ccadic/RPi0WGameStation/20171103_110615.jpg

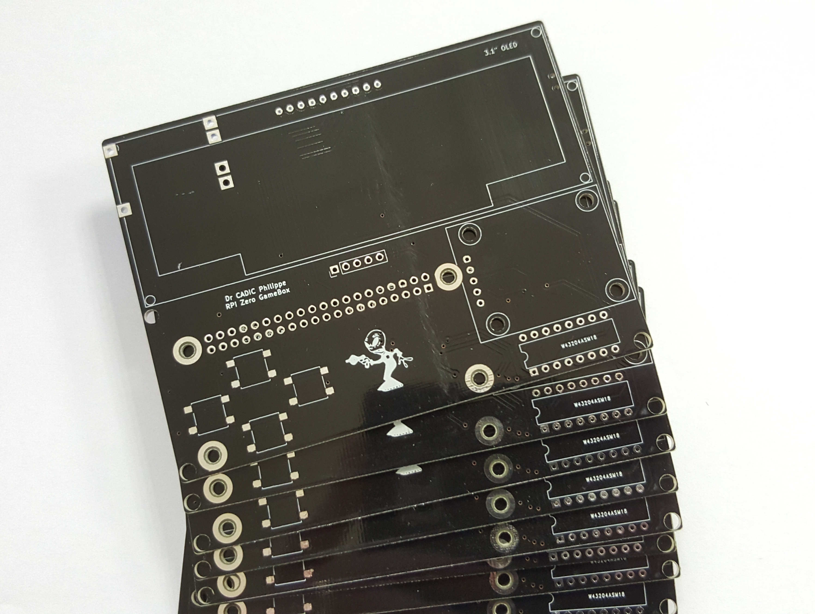
20171103_110615.jpg
