ccadic/RPi0WGameStation/23473068_10214847813298589_1204559804403609338_n.jpg

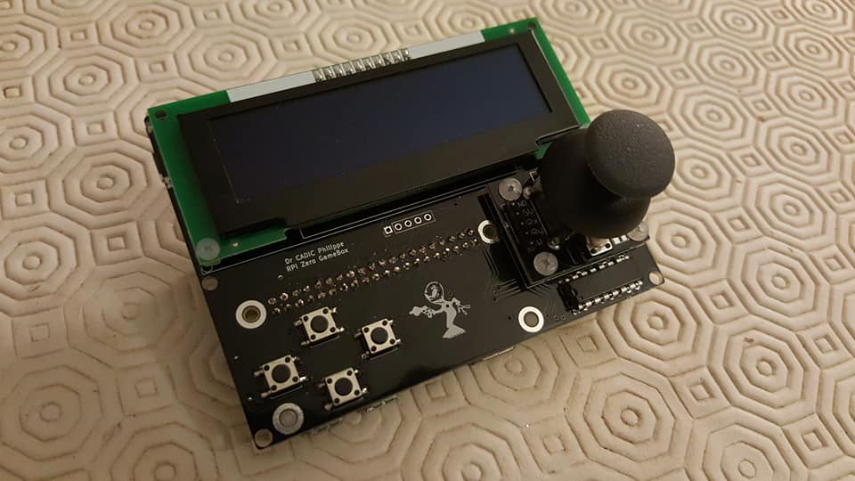
23473068_10214847813298589_1204559804403609338_n.jpg
