ccadic/RPi0WGameStation/README.md

# RPi0WGameStation
PCB to make a RPI0 based game station or WIFI remote controler
