ccadic/RPi0WGameStation/Projet de Console de jeu Raspberry Pi 0.pdf

# Projet de Console de jeu Raspberry Pi 0

DR PHILIPPE CADIC (https://www.linkedin.com/in/dr-philippe-cadic-883a15122/)

Ce mois si , j'ai continué à découvrir le logiciel KICAD (http://kicad-pcb.org/) pour concevoir un petit projet rigolo: une petite console de jeu basée sur une architecture simple de type Raspberry Pi Zero (https://www.raspberrypi.org/products/raspberry-pi-zero/) . Le challenge était sympathique et intéressant pour un débutant en conception de PCB. Derrière cette réalisation, il y a l'idée d'en faire une plateforme de pilotage de robot Pepper ou Buddy.

La recherche des composants pouvant être intéressants s'est faite, le plus simplement du monde, par rédaction d'un rapide cahier des charges:

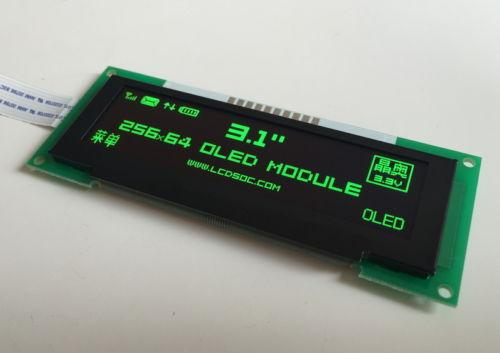
[picture p3: figure]

- Un raspberry pour le coeur du système
- Un écran un peu sympa OLED monochrome avec une librairie qui serait aisée à implémenter sous RPI Linux.
- Une batterie de bonne capacité, rechargeable via USB et amovible pour les longs trajets en train/avion où, forcément il faudrait disposer de munitions.
- Un Joystick bas prix
- Une collection de 4 ou 5 boutons
- Un interrupteur pour .... à votre avis?
- Un circuit chargeur de batterie

### Les recherches composants

Ces recherches ont été faites sur Aliexpress (https://fr.aliexpress.com/) (sauf pour le RPi). (https://fr.aliexpress.com/item/2017-Raspberry-Pi-Zero-W-Board-1GHz-CPU-512MB-RAM-with-WIFI-Bluetooth-RPI-0-W/32802521209.html) Vous trouverez les liens vers les composants , pour éventuellement, cheminer dans mes pas.

- 18650 Batterie (https://fr.aliexpress.com/item/2pcs-lot-18650-battery-ncr18650b-3400mah-for-panasonic-new-100-original-3-7v-rechargeable-battery-hot/32659824635.html) 3.7v

- Le porte batterie (https://fr.aliexpress.com/item/5Pcs-lot-18650-Battery-Holder-SMD-18650-Battery-Storage-Box-High-Quality-With-Bronze-Pins-TBH/32542773400.html)
- L'écran OLED (https://fr.aliexpress.com/item/3-1-inch-10PIN-Green-OLED-Module-SSD1322-Drive-IC-256-64-SPI-Interface-5V/32264789782.html) 3,1"
- Les boutons SMD (https://fr.aliexpress.com/item/1000pcs-MINI-micro-Slide-Switch-On-OFF-2-Position-1P2T-SPDT-Miniature-Horizontal-Slide-Switch-SMD/32770868105.html) et ceux ci (https://fr.aliexpress.com/item/Details-about-140pcs-14types-Momentary-Tact-Tactile-Push-Button-Switch-SMD-Assortment-Kit-Set-Life-100000/32698545030.html) aussi
- Un Joystick Arduino KY-023 (https://fr.aliexpress.com/item/1PCS-LOT-Dual-axis-XY-Joystick-Module-Free-Shipping-for-arduino-KY-023/32725960920.html)
- Un système de recharge de batterie (https://fr.aliexpress.com/item/2pcs-Lithium-Battery-Charger-Module-1A-Micro-USB-5V-18650-TP4056-MIni-USB-Lithium-Battery-Charging/32593738140.html) 1 A USB de type TP4056 (pas besoin de réinventer la roue. Ca existe tout fait , facile à ajouter)
- Un set de résistances (https://fr.aliexpress.com/item/1206-10K-ohm-5-1-4W-Resistor-3216-103-Chip-resistor-500Pcs-Lot/32601535320.html) SMD 1206.
- Des strip sockets 40 pins (https://fr.aliexpress.com/item/10-Pcs-Lot-Raspberry-Pi-Zero-Male-Stackable-Prototyping-Header-Right-Angle-2x20-Pins-Size-3/32570732891.html) (2x20) pour RPi
- Un circuit intégré MCP3008 (https://fr.aliexpress.com/item/10-PCS-LOT-MCP3008-I-P-MCP3008-DIP-Original/32735896933.html) (indispensable pour convertir l'analogique du joystick en signal numérique)
- Des vis et écrous en plastique

### La conception de la plaque imprimée

Pas de grosse difficulté pour ce projet puisque tout a déjà été inventé depuis longtemps. Il s'agit juste d'assembler le Lego sous KICAD. Schéma basique. Le plus long n'étant, finalement, que la partie développement des librairies de composants, des empreintes (footprints) et des rendering 3D de composants. (Lien GITHUB) (https://github.com/ccadic/RPi0WGameStation)

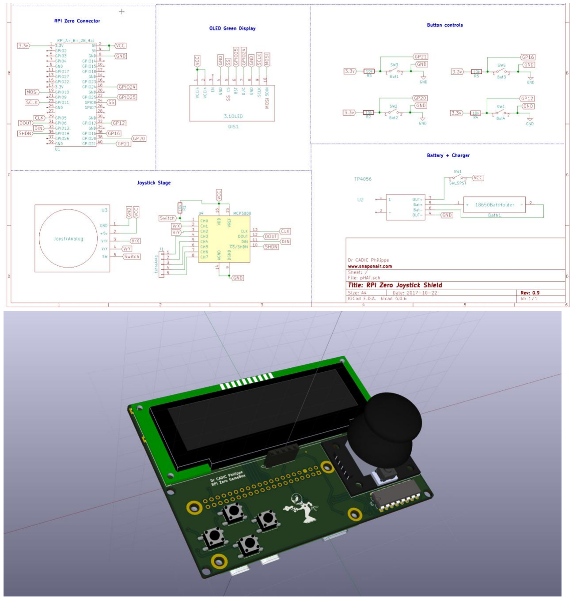
[picture p4: figure]

La plaque PCB est double face. J'ai choisi des composants SMD 1206 pour simplifier la réalisation des soudures à la main. L'assemblage nécessite quelques précautions dans sa chronologie: monter le joystick d'abord, puis souder les boutons et le MCP3008, enfin monter et souder le RPi ZeroW, la plaque TP4056 et en dernier l'écran. La plaque imprimée permet d'avoir 5 entrées analogiques de plus. je ne l'ai pas cablée.

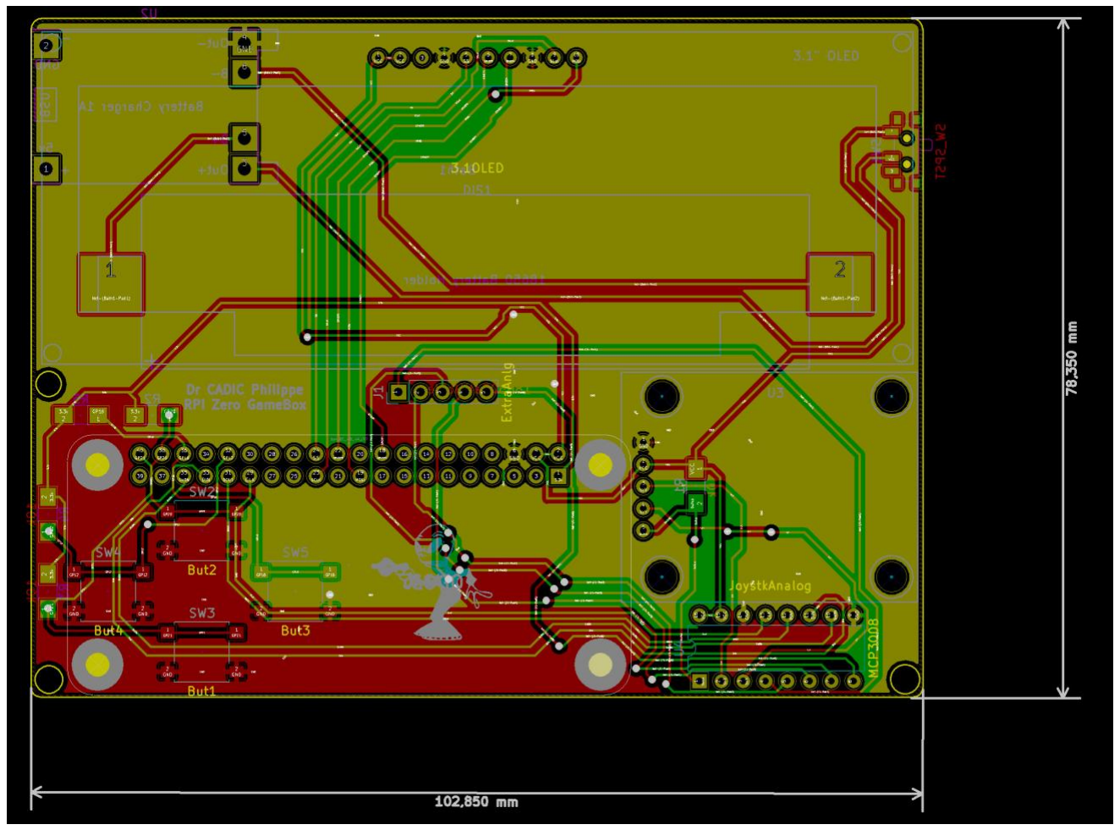
[picture p5: figure]

Si vous voulez avoir une plaque PCB toute faite c'est ici, (https://www.tindie.com/products/electronictrik/rpi0w-game-station-pcb-only/) je n'ai qu'un stock limité.

Une fois montée, ca donne ceci

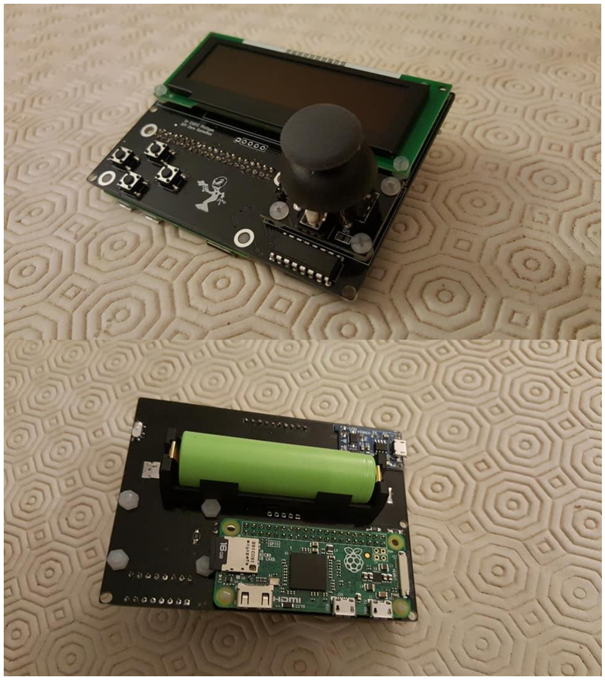
[picture p6: figure]

### Charger le logiciel et le configurer

Rien de sorcier pour l'installation: une Raspbian stretch lite (https://www.raspberrypi.org/downloads/raspbian/) , une carte SD 32 Go (la plus rapide possible en transfert de data).

Le driver SSD1322 ne pose pas de vrai problème d'installation. Il suffit d'aller sur Luma-Oled (http://luma-oled.readthedocs.io/en/latest/intro.html) et de suivre, pas à pas l'installation.

Une fois l'installation complete, il convient de concevoir un script de lancement du logiciel/jeu python , de chmoder 755 pour le rendre exécutable, de le mettre dans /root/startup/mon_script . Puis de modifier votre /etc/rc.local en y ajoutant la ligne de commande.

Pour votre information, bien que nous testé, il existe des sources github des drivers oled ssd1322 (https://github.com/presslab-us/fbtft) pour rediriger la console sur l'ecran oled

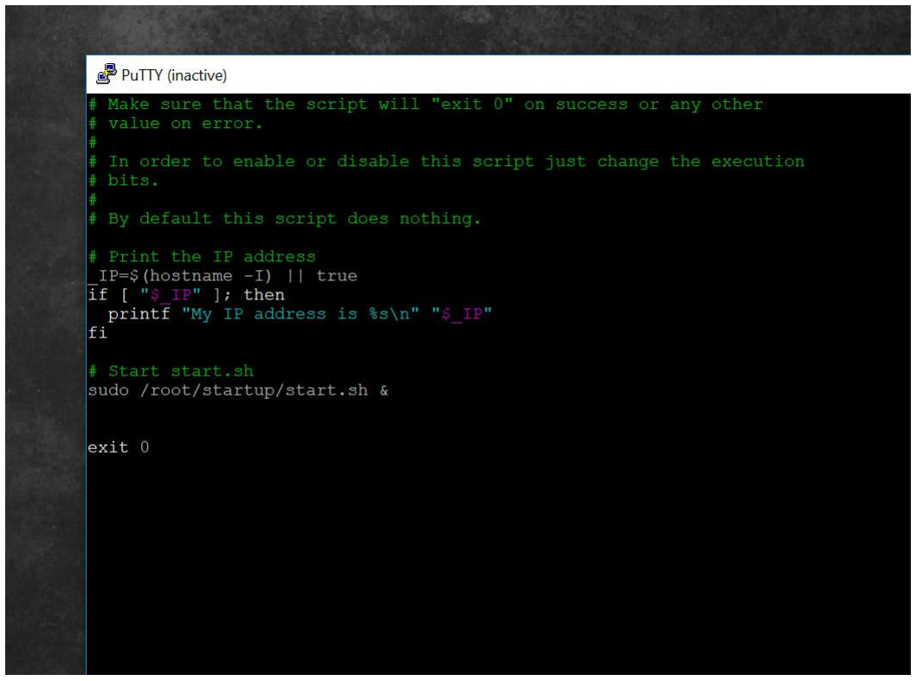
[picture p7: figure]

Ce qui permet de tester le système sur un script d'exemple livré avec LUMA OLED.

Il ne vous reste plus qu'à développer les jeux.

En espérant que ce petit article vous aura incité à vous lancer aussi.
