ccadic/RPi0WGameStation/23473220_10214847813778601_2224835878698296040_n.jpg

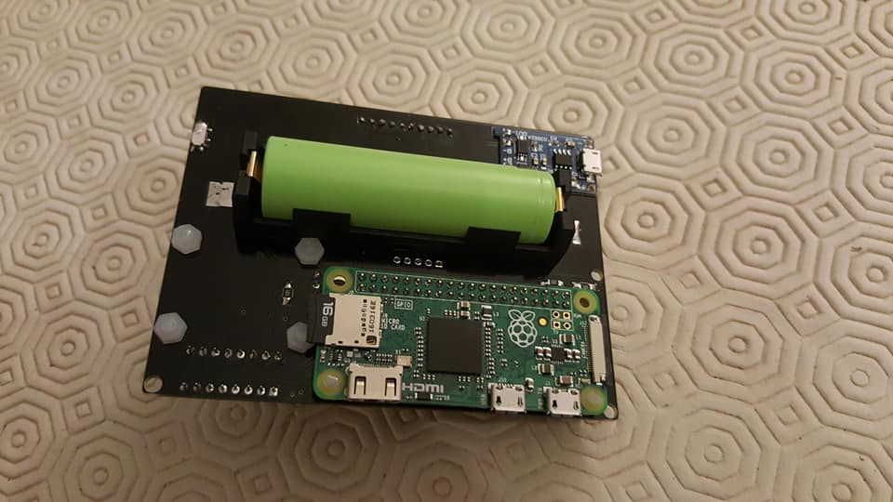
23473220_10214847813778601_2224835878698296040_n.jpg
