ccadic/RPi0WGameStation/front_n.jpg

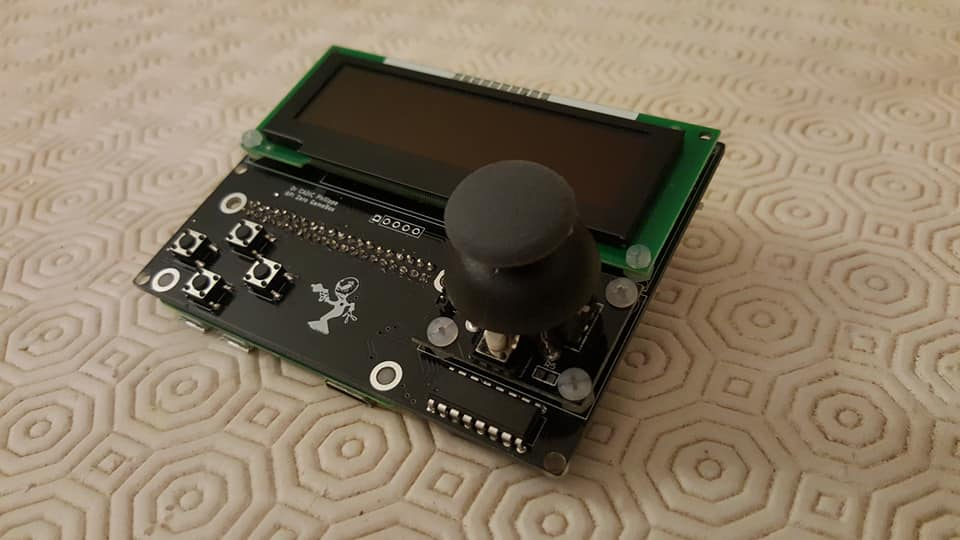
front_n.jpg
