ccadic/RPi0WGameStation/pHAT/console2.jpg

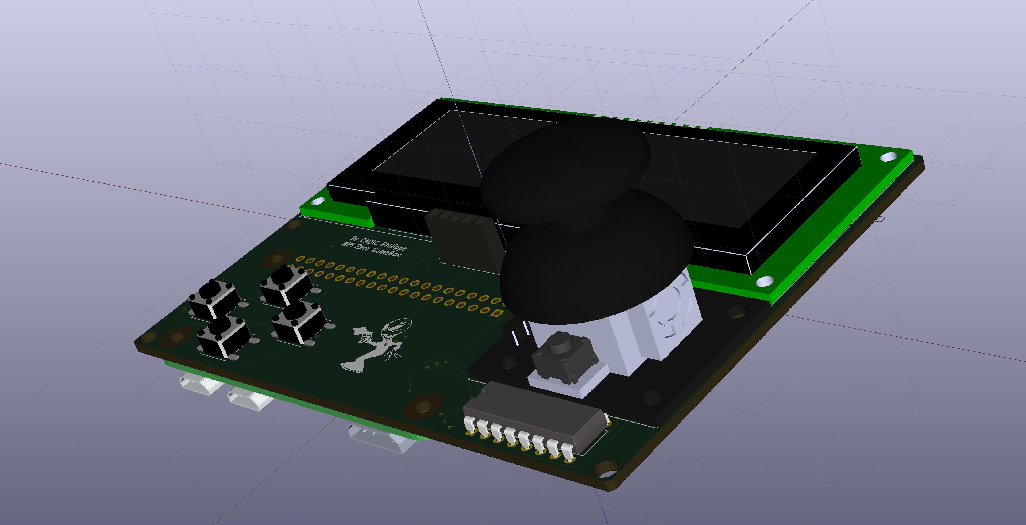
pHAT/console2.jpg
