ccadic/RPi0WGameStation/pHAT/console3.jpg

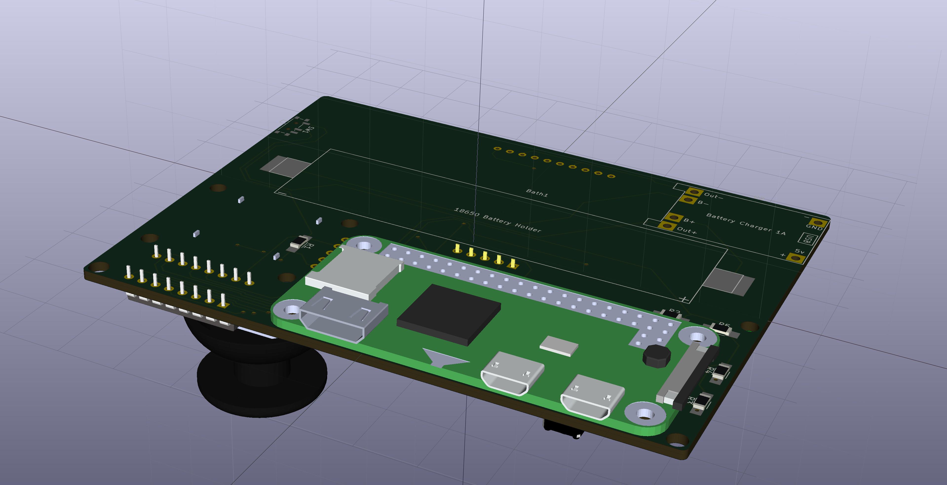
pHAT/console3.jpg
