ccadic/RPi0WGameStation/pHAT/console4.jpg

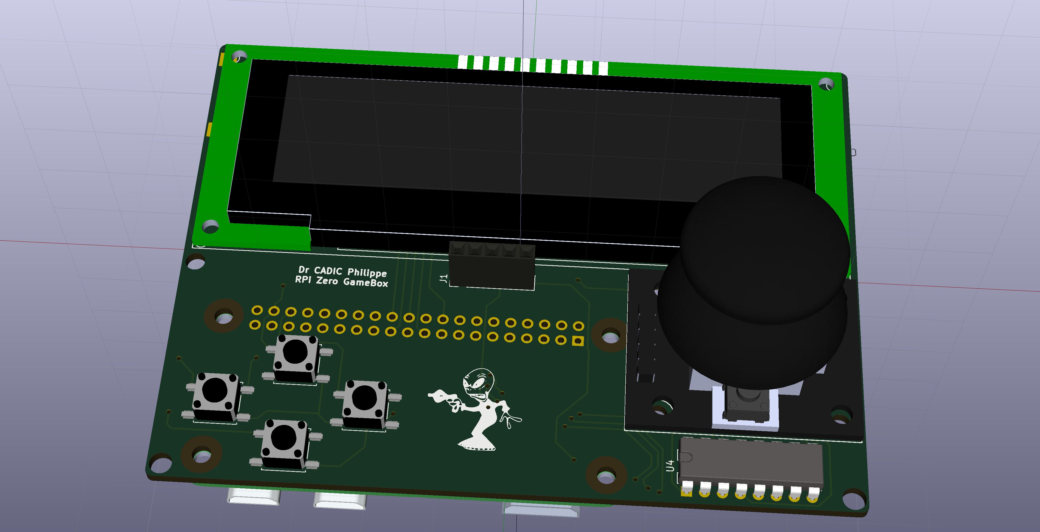
pHAT/console4.jpg
