ccadic/RPi0WGameStation/pHAT/console5.jpg

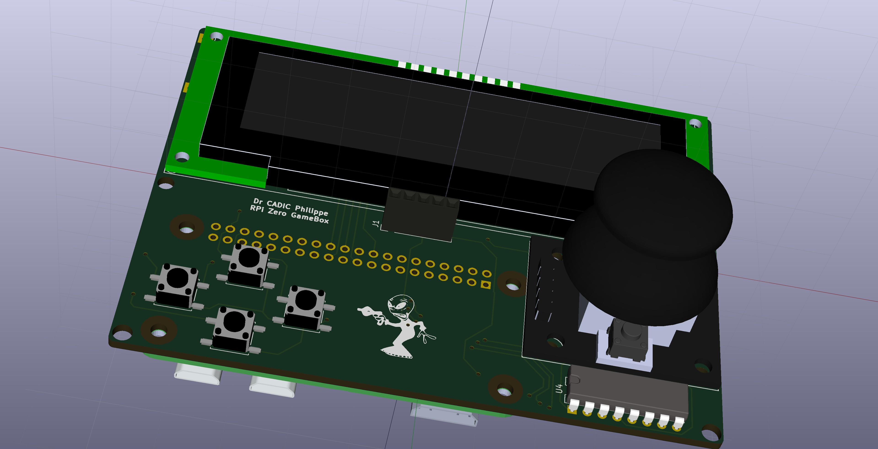
pHAT/console5.jpg
