ccadic/RPi0WGameStation/pHAT/console6.jpg

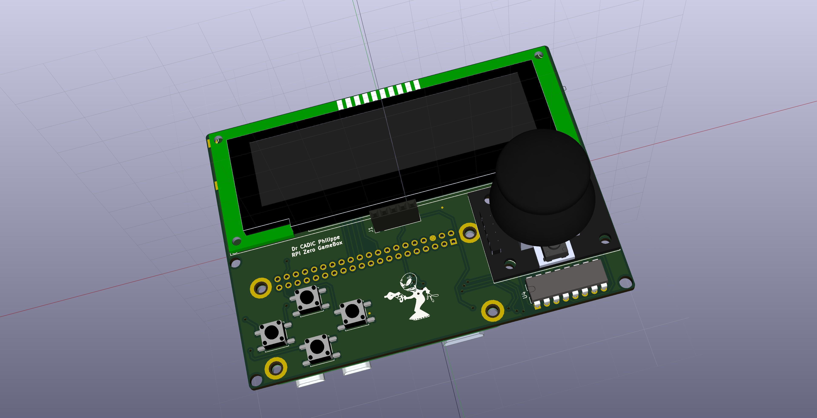
pHAT/console6.jpg
