ccadic/RPi0WGameStation/pHAT/console7.jpg

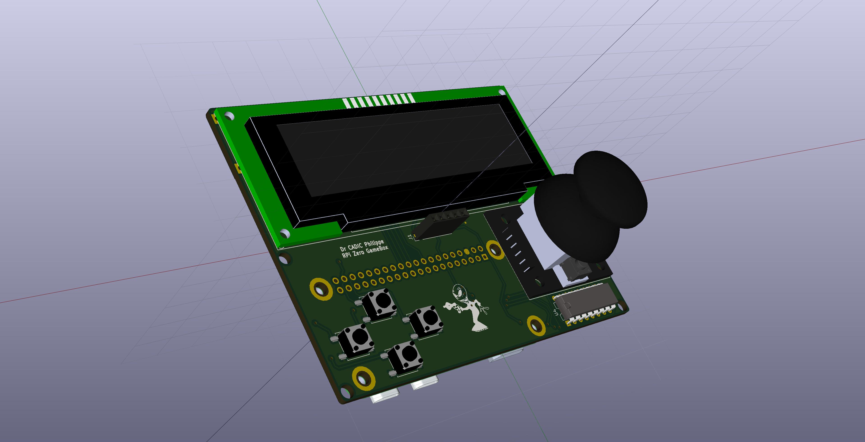
pHAT/console7.jpg
