ccadic/RPi0WGameStation/pHAT/console8.jpg

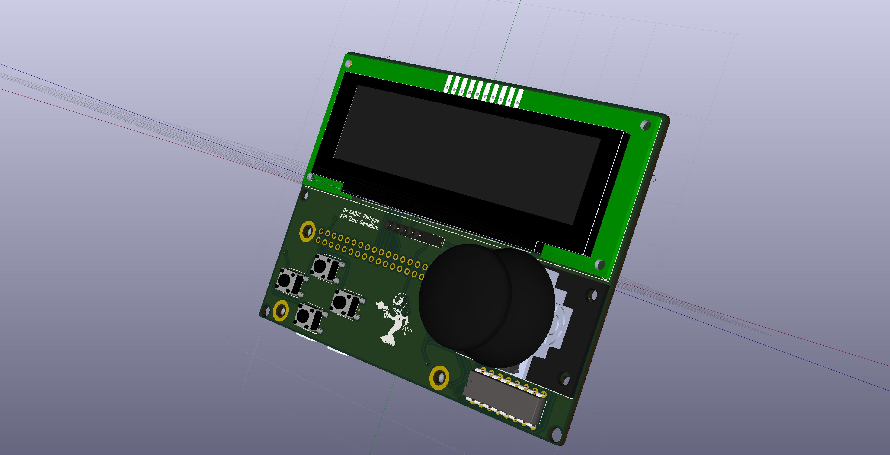
pHAT/console8.jpg
