ccadic/RPi0WGameStation/pHAT/console9.jpg

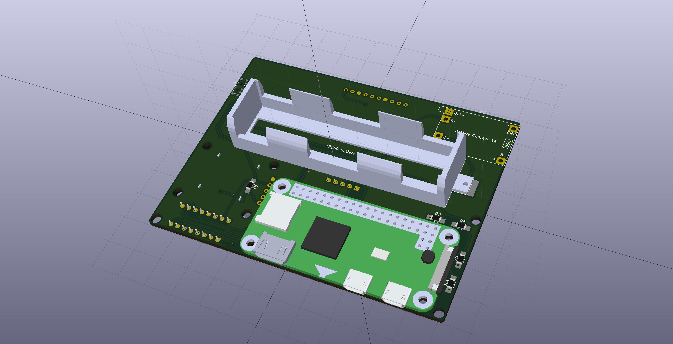
pHAT/console9.jpg
