ccadic/RPi0WGameStation/pHAT/console.jpg

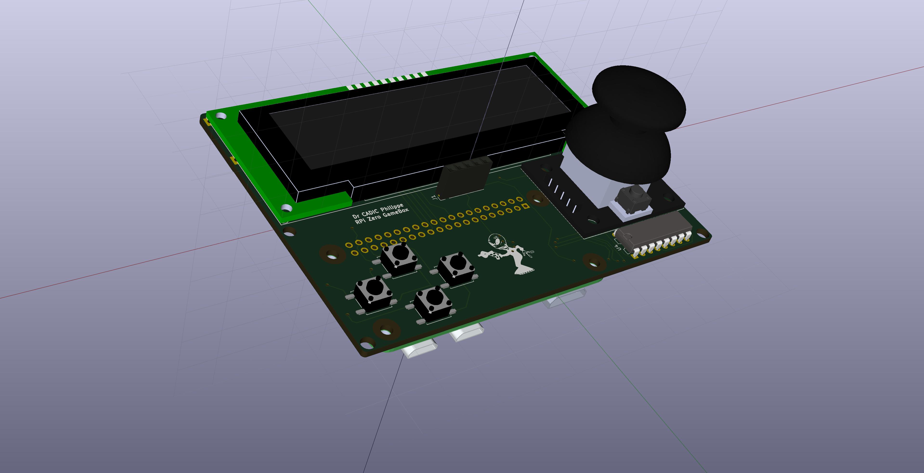
pHAT/console.jpg
