ccadic/RPi0WGameStation/Diagram.pdf

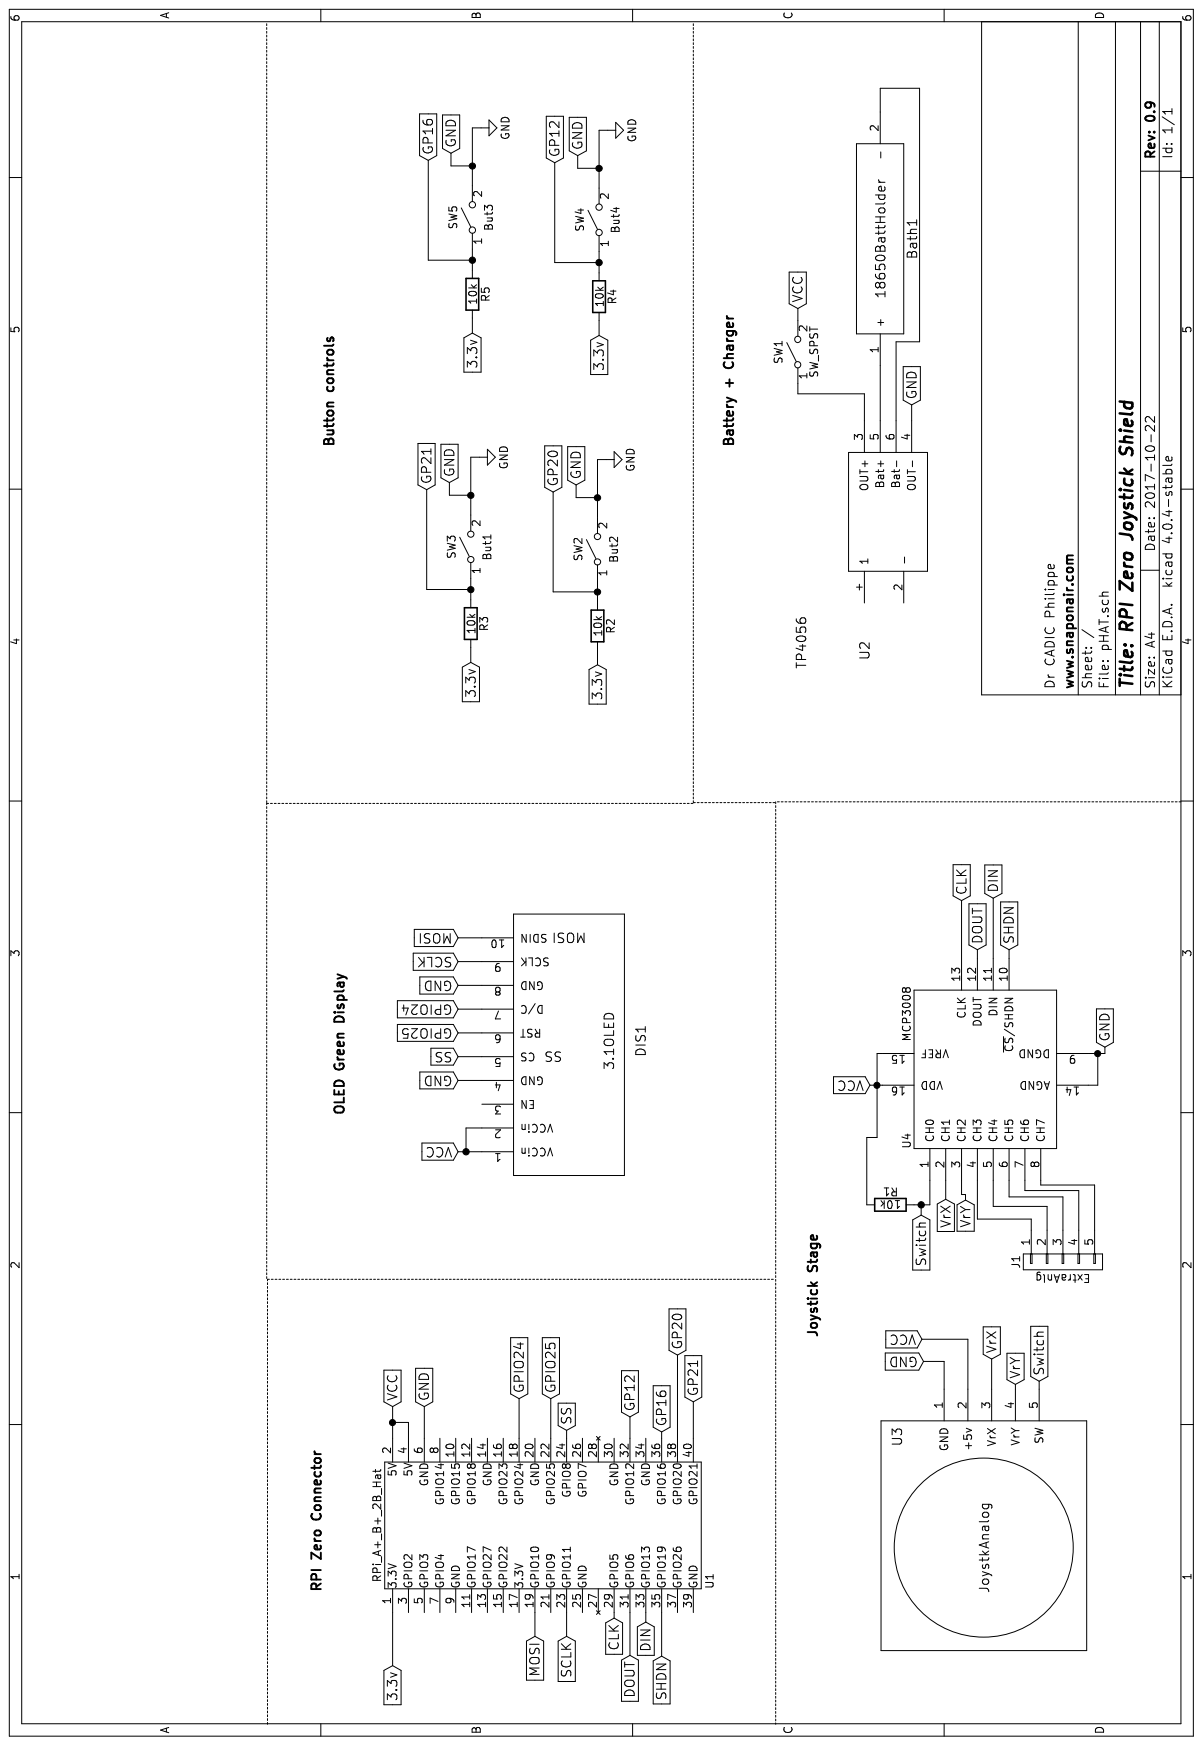
[picture p19: page 1]
