ccadic/RPi0WGameStation/pHAT/pHAT.kicad_pcb

## KiCad design pHAT/pHAT.kicad_pcb (2017-11-20)

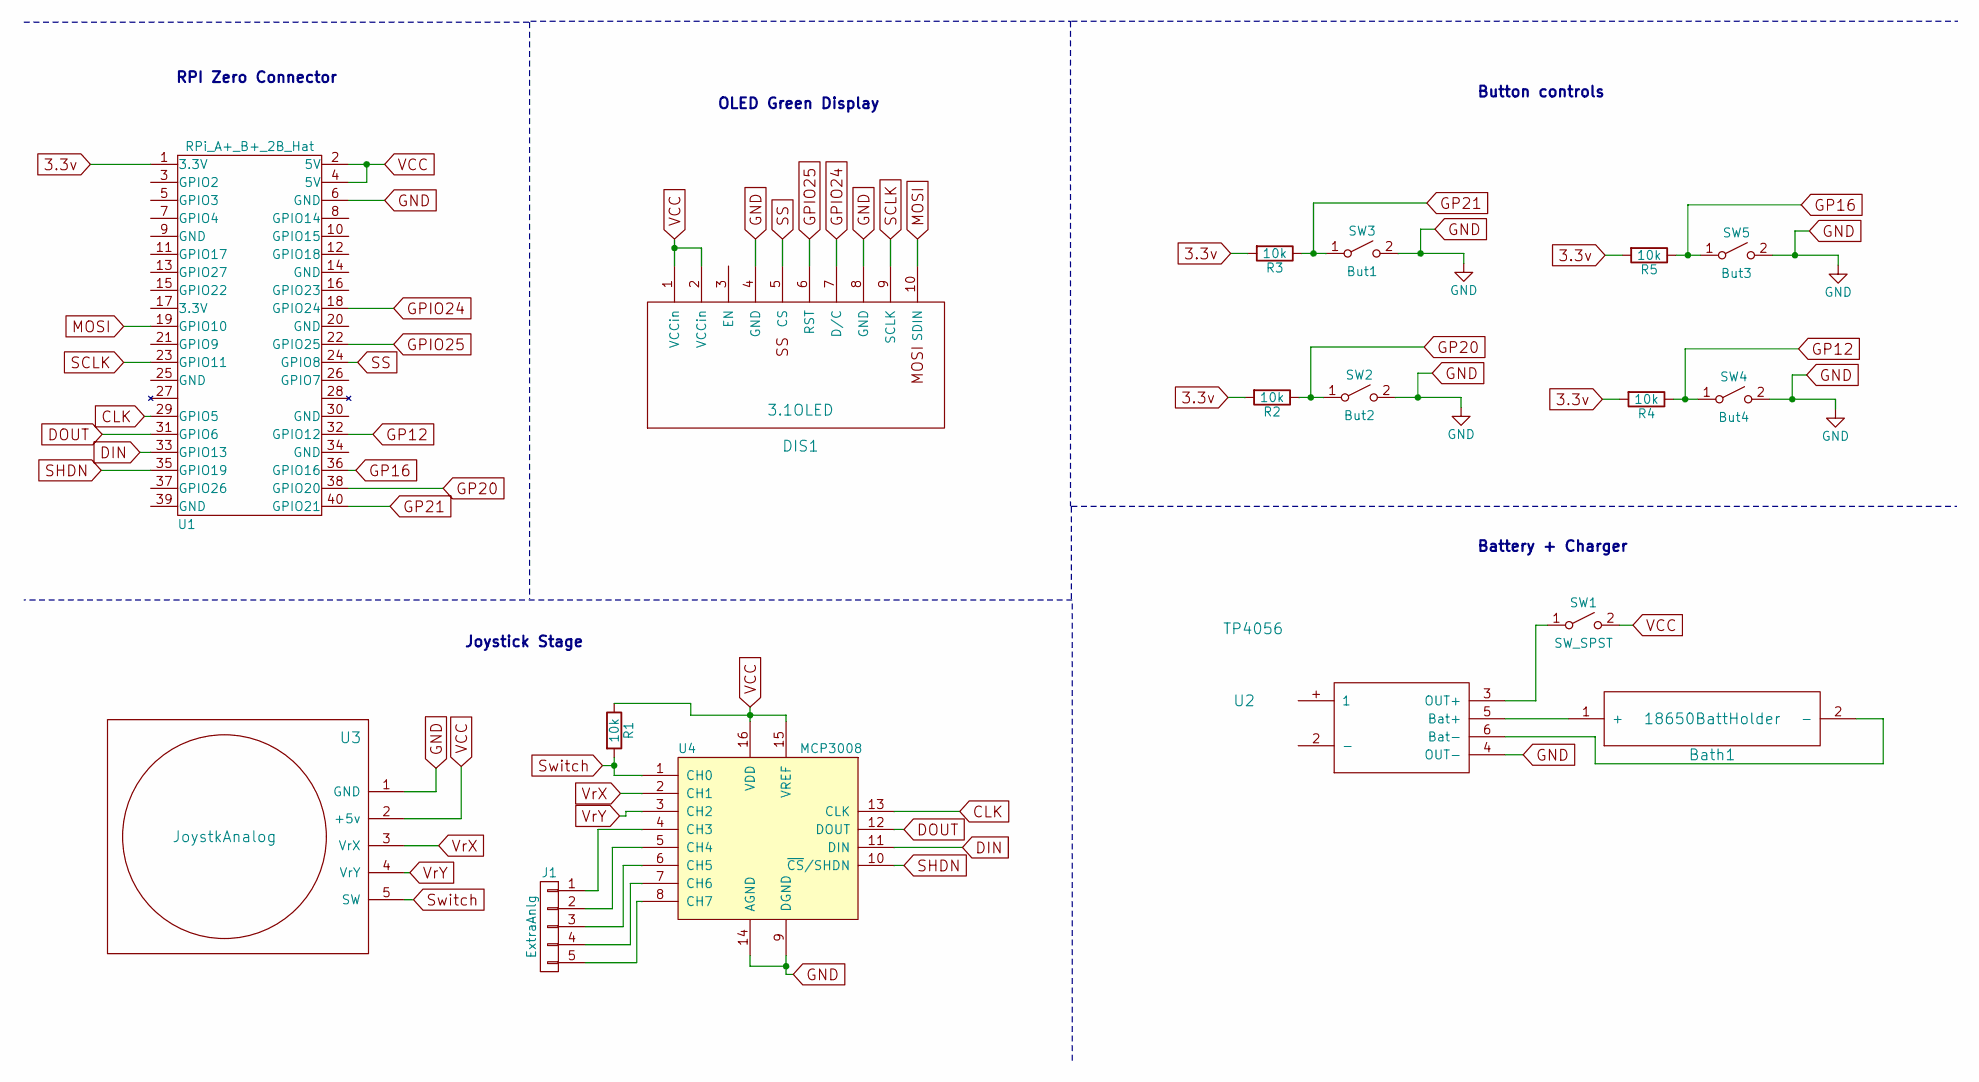
[picture p20: schematic pHAT.sch, RPI Zero Joystick Shield]

Parts:
Bath1: 18650BattHolder
DIS1: 3.1OLED; 3_1_OLED
J1: ExtraAnlg; Socket_Strip_Straight_1x05_Pitch2.54mm
R1, R2, R3, R4, R5: 10k; R_1206_HandSoldering
SW1: SW_SPST; SW_SPDT_PCM12
SW2: But2; SW_SPST_B3S-1000
SW3: But1; SW_SPST_B3S-1000
SW4: But4; SW_SPST_B3S-1000
SW5: But3; SW_SPST_B3S-1000
U1: RPi_A+_B+_2B_Hat; z_RPiZero_Hat_NPTH
U2: TP4056; TP4056-18650
U3: JoystkAnalog
U4: MCP3008; DIP-16_W7.62mm

Connections:
3.3v: R2.2, R3.2, R4.2, R5.2, U1.1 (3.3V)
CLK: U1.29 (GPIO5), U4.13 (CLK)
DIN: U1.33 (GPIO13), U4.11 (DIN)
DOUT: U1.31 (GPIO6), U4.12 (DOUT)
GND: DIS1.4 (GND), DIS1.8 (GND), SW2.2 (B), SW3.2 (B), SW4.2 (B), SW5.2 (B), U1.6 (GND), U2.4 (OUT-), U3.1 (GND), U4.9 (DGND), U4.14 (AGND)
GP12: R4.1, SW4.1 (A), U1.32 (GPIO12)
GP16: R5.1, SW5.1 (A), U1.36 (GPIO16)
GP20: R2.1, SW2.1 (A), U1.38 (GPIO20)
GP21: R3.1, SW3.1 (A), U1.40 (GPIO21)
GPIO24: DIS1.7 (D/C), U1.18 (GPIO24)
GPIO25: DIS1.6 (RST), U1.22 (GPIO25)
MOSI: DIS1.10 (SDIN), U1.19 (GPIO10)
unnamed: Bath1.1 (+), U2.5 (Bat+)
unnamed: Bath1.2 (-), U2.6 (Bat-)
unnamed: J1.1, U4.4 (CH3)
unnamed: J1.2, U4.5 (CH4)
unnamed: J1.3, U4.6 (CH5)
unnamed: J1.4, U4.7 (CH6)
unnamed: J1.5, U4.8 (CH7)
unnamed: SW1.1 (A), U2.3 (OUT+)
SCLK: DIS1.9 (SCLK), U1.23 (GPIO11)
SHDN: U1.35 (GPIO19), U4.10 (~CS~/SHDN)
SS: DIS1.5 (CS), U1.24 (GPIO8)
Switch: R1.2, U3.5 (SW), U4.1 (CH0)
VCC: DIS1.1 (VCCin), DIS1.2 (VCCin), R1.1, SW1.2 (B), U1.2 (5V), U1.4 (5V), U3.2 (+5v), U4.15 (VREF), U4.16 (VDD)
VrX: U3.3 (VrX), U4.2 (CH1)
VrY: U3.4 (VrY), U4.3 (CH2)

Notes on the sheet:
Battery + Charger
Joystick Stage
RPI Zero Connector
OLED Green Display
Button controls

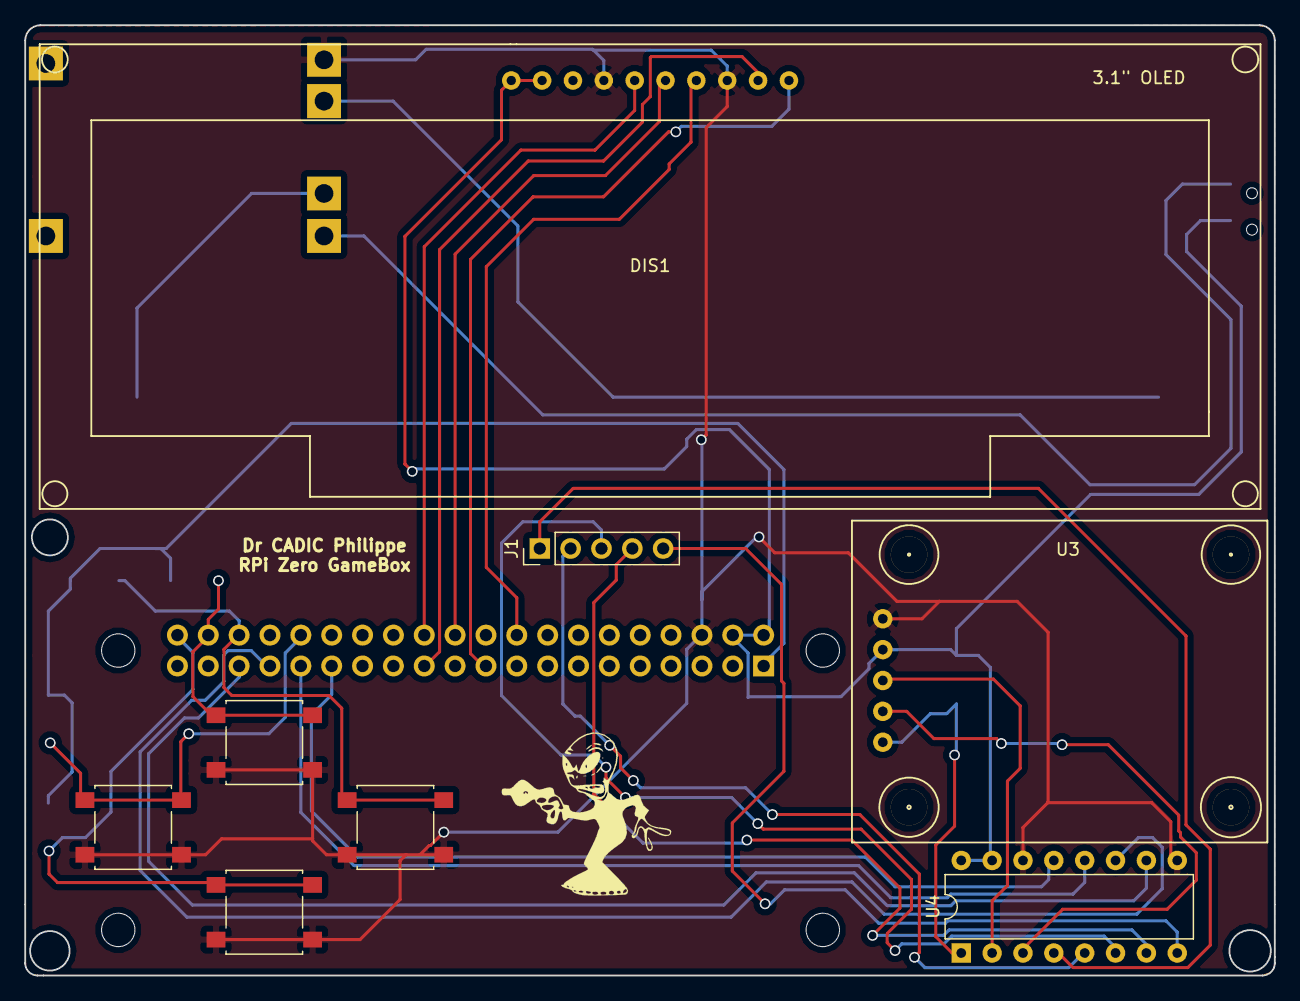
[picture p21: board pHAT.kicad_pcb from above]

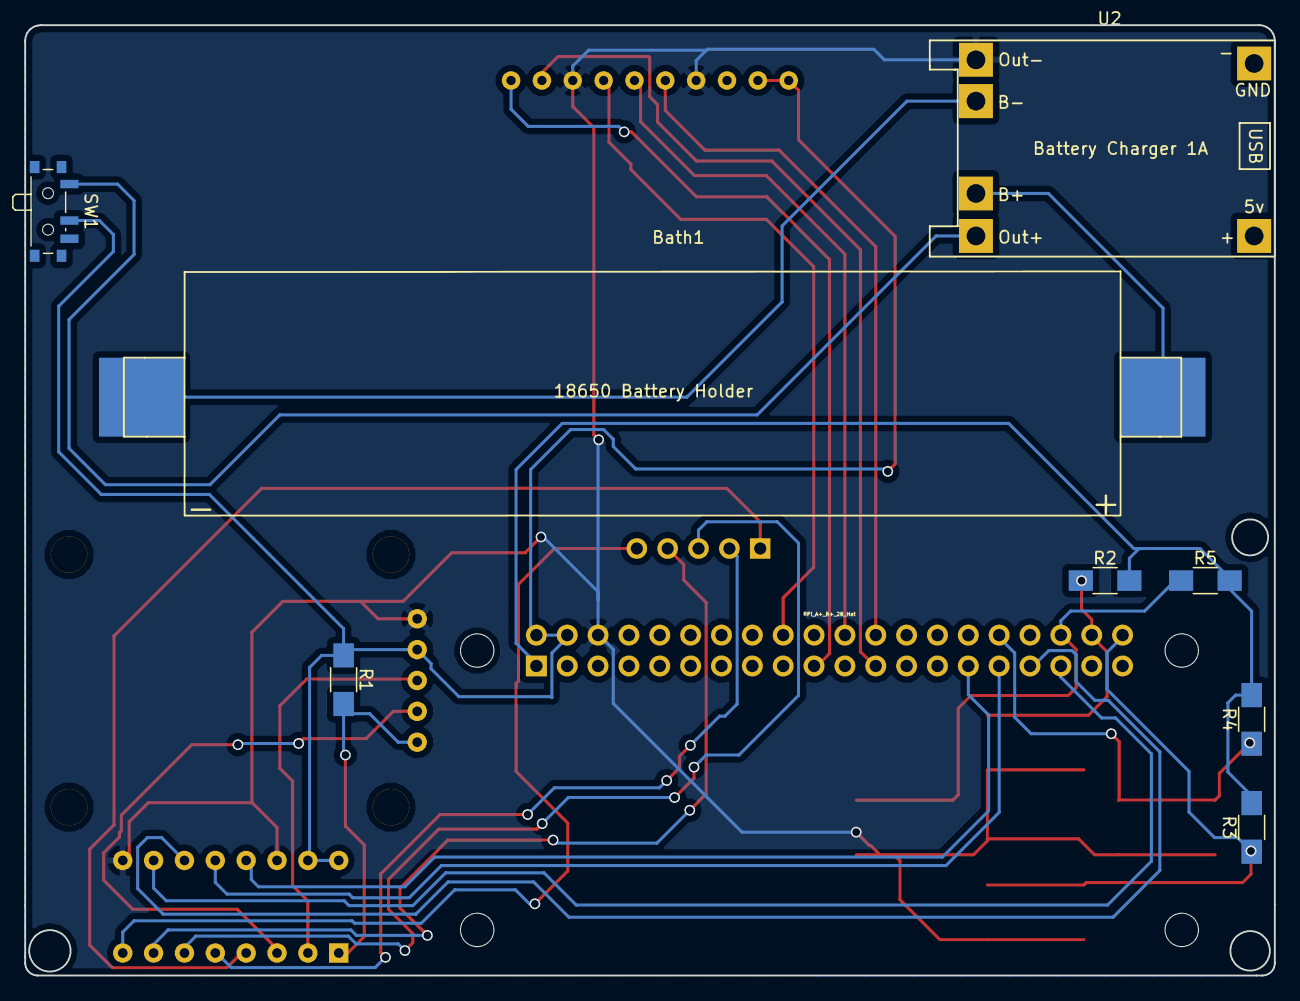
[picture p22: board pHAT.kicad_pcb from below]

Board: 2 copper layers, 102.9 x 78.2 mm, 17 parts (9 on the bottom side), 27 nets.
